granthaack/TinyTari/both.png

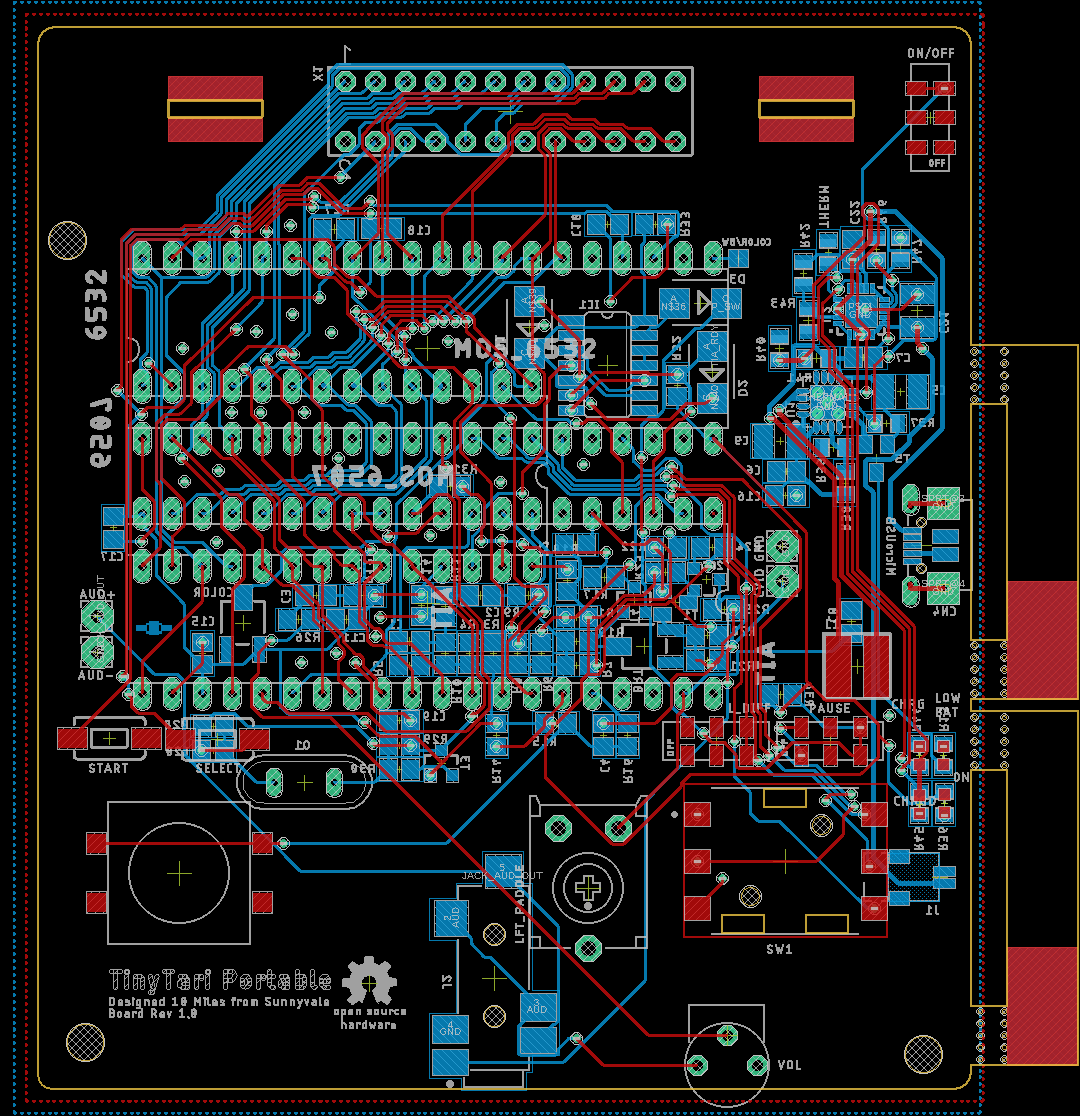
both.png
