granthaack/TinyTari/bottom.png

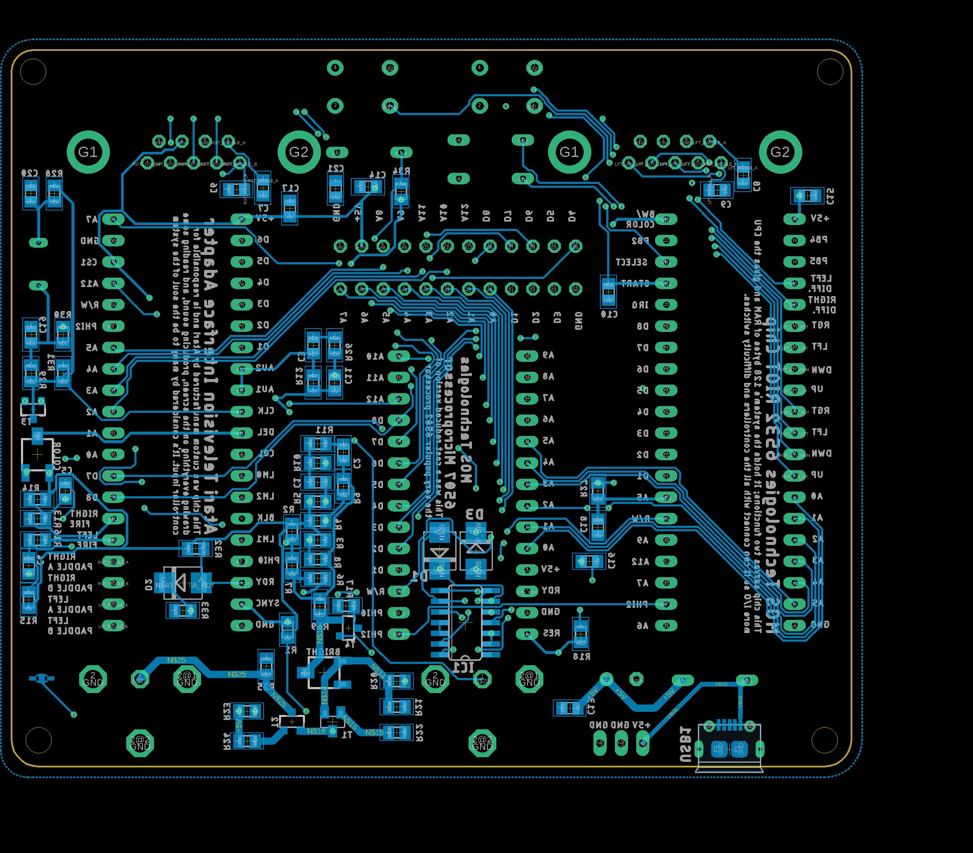
bottom.png
