granthaack/TinyTari/top.png

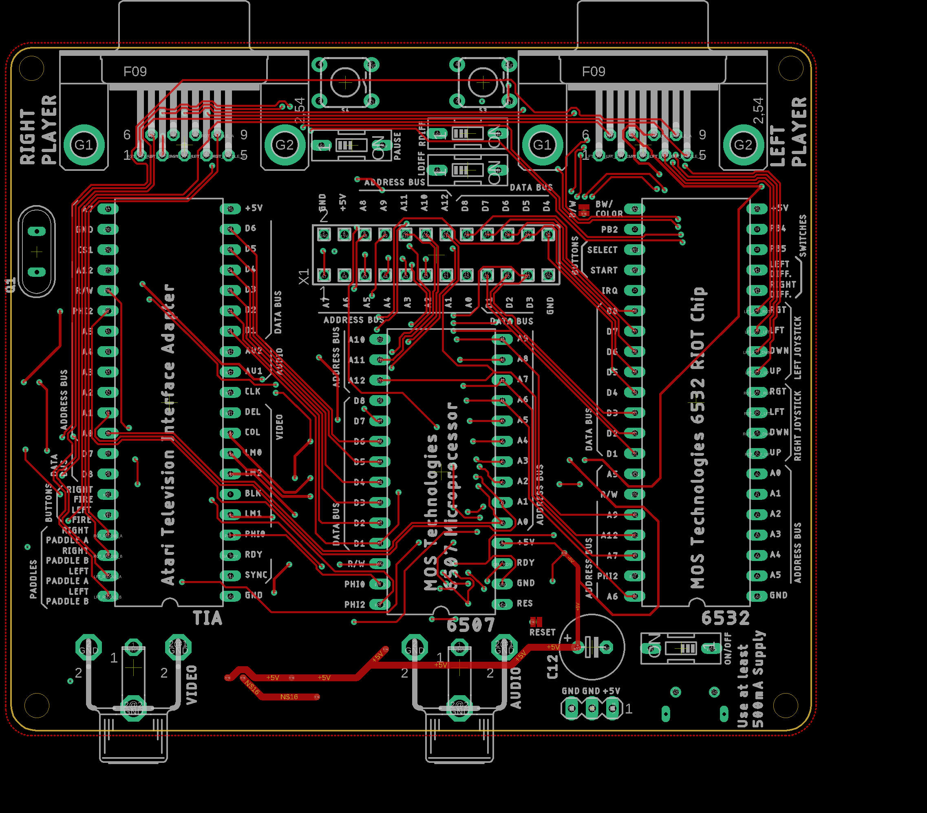
top.png
