granthaack/TinyTari/porta_stella.pdf

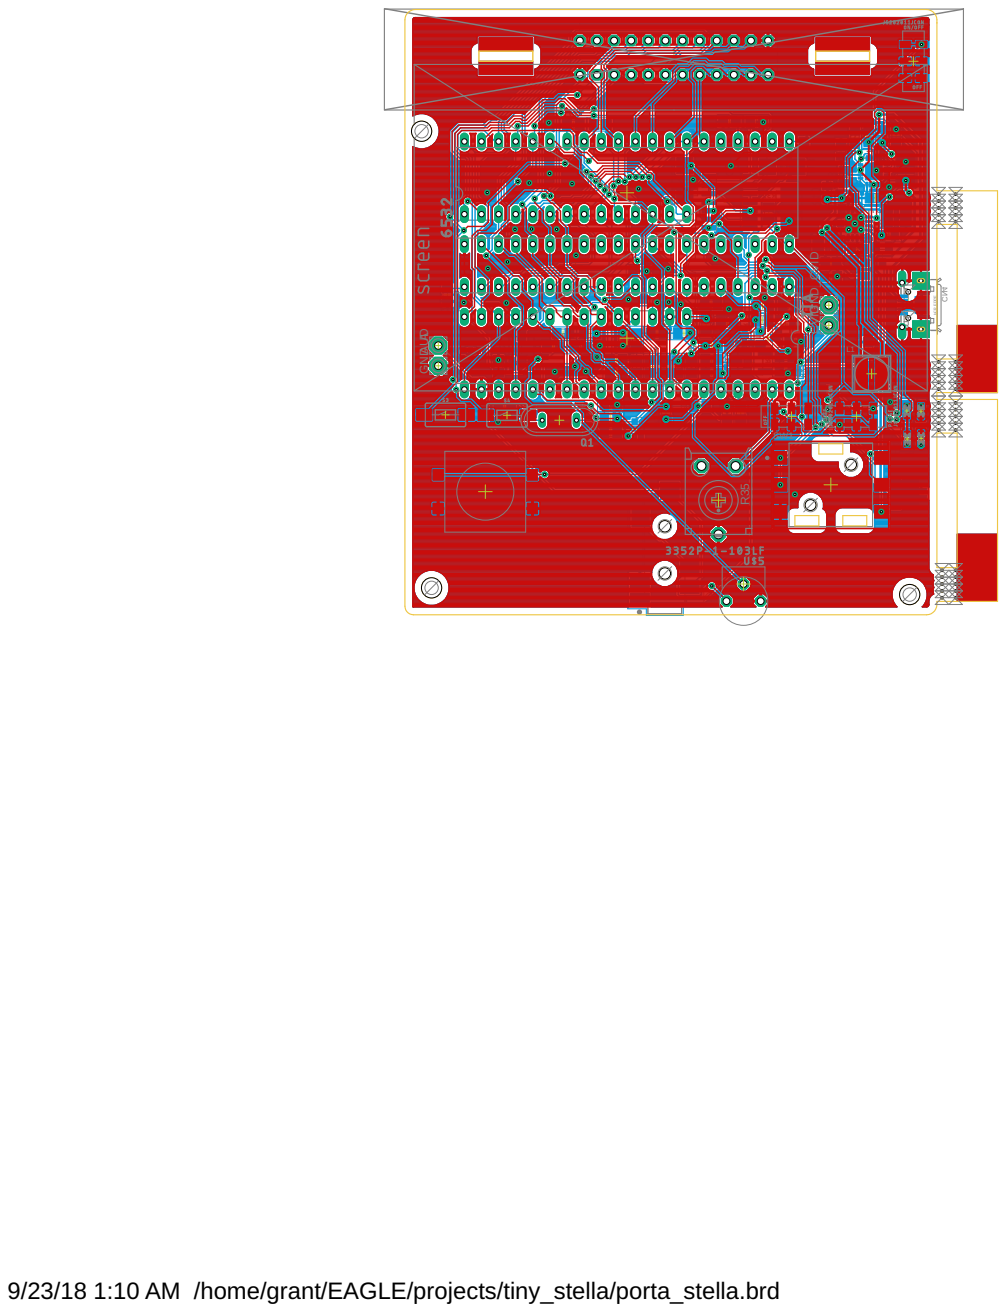
[picture p4: page 1]

9/23/18 1:10 AM /home/grant/EAGLE/projects/tiny_stella/porta_stella.brd
