granthaack/TinyTari/porta_stella.brd

## EAGLE design porta_stella.brd (2018-09-25)

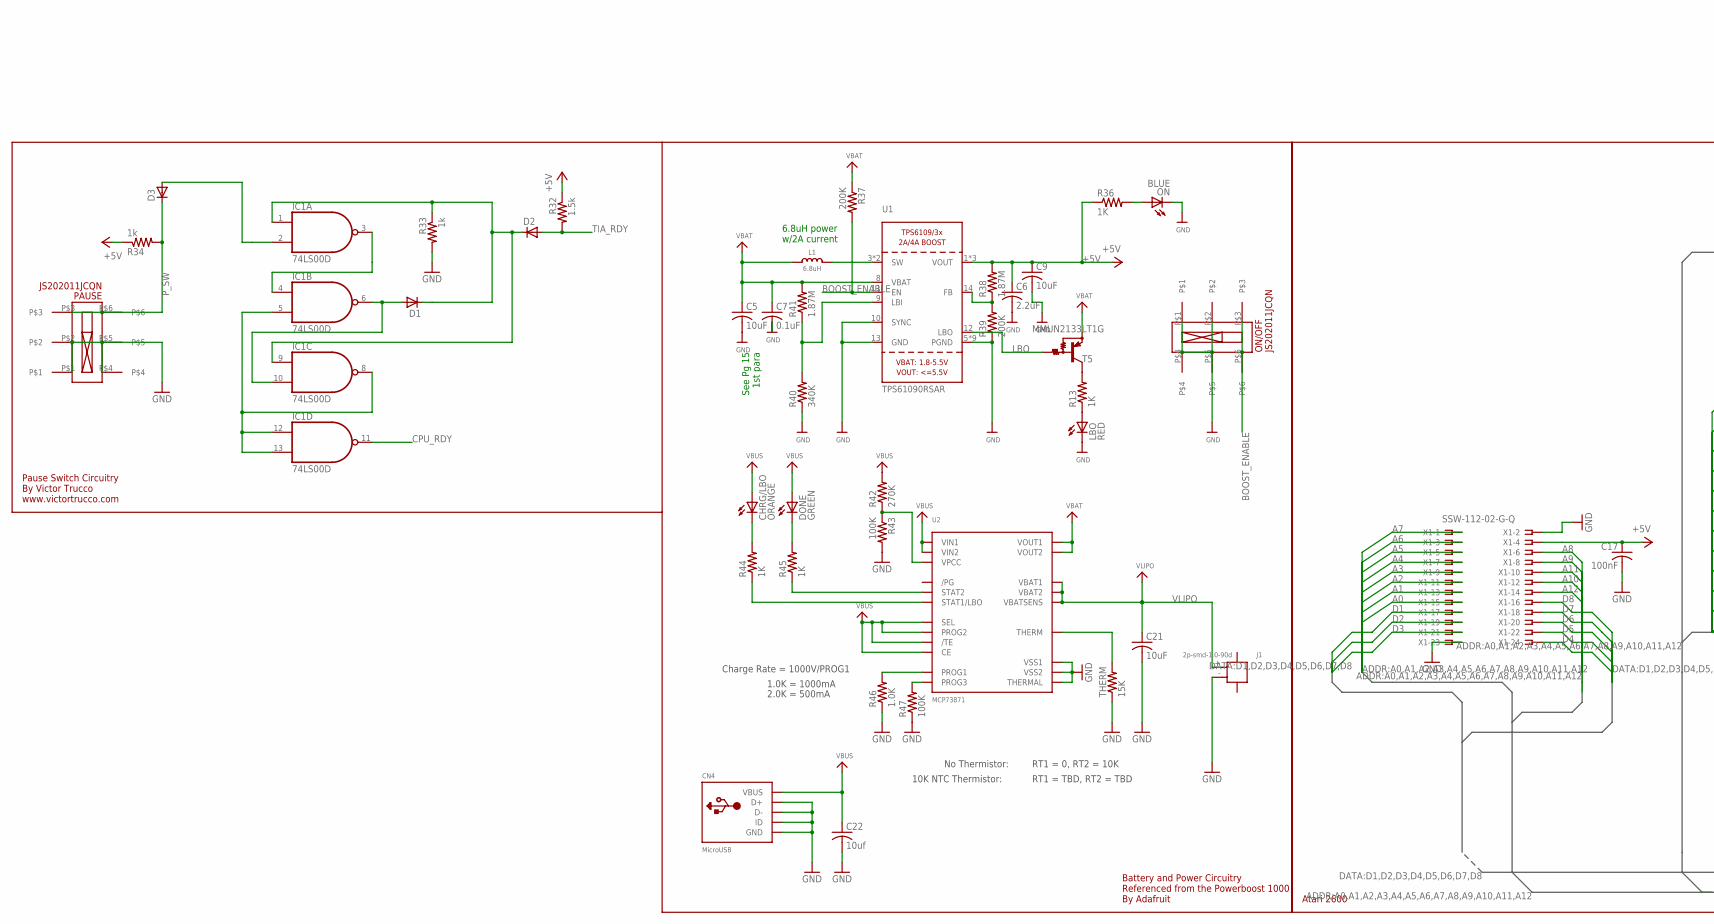
[picture p5: schematic porta_stella.sch, part in row 1, column 1]

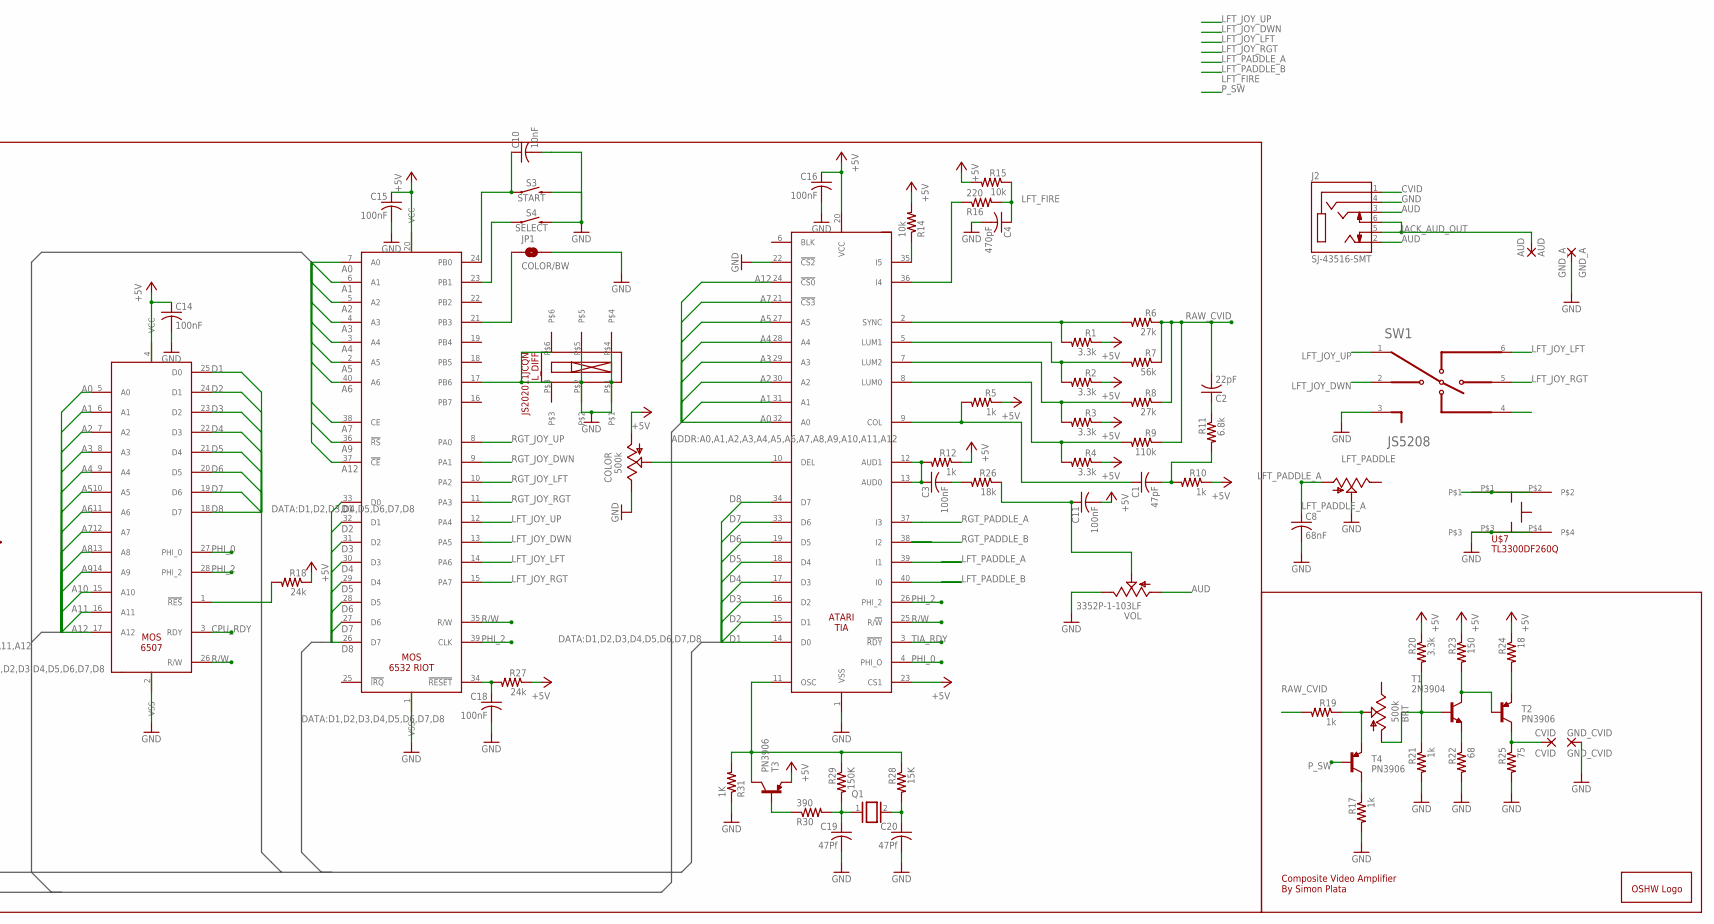
[picture p6: schematic porta_stella.sch, part in row 1, column 2]

Parts:
6507: MOS_6507; DIL28
6532: MOS_6532; DIL40
AUD: AUD; 2,54/1,1
BRT: 500k; 3223G
C1: 47pF; C0805
C2: 22pF; C0805
C3, C11, C14, C15, C16, C17, C18: 100nF; C0805
C4: 470pF; C0805
C5, C9, C21: 10uF; C1210
C6: 2.2uF; C0805
C7: 0.1uF; C0805
C8: 68nF; C0805
C10: 10nF; C0805
C19, C20: 47Pf; C0805
C22: 10uf; C0805
CHRG/LBO: ORANGE; ADAFRUIT_CHIPLED_0603
CN4: MicroUSB; 4UCONN_20329
COLOR: 500k; 3223G
CVID: CVID; 2,54/1,1
D1, D2, D3: DIODE_E-; DIODE_SMB
DONE: GREEN; ADAFRUIT_CHIPLED_0603
GND_A: GND_A; 2,54/1,1
GND_CVID: GND_CVID; 2,54/1,1
GOLD_ORB_SM1: OSHWLOGOLOGO5MM; OSHW_5MM
IC1: 74LS00D; SO14
J1: 2p-smd-1.0-90d; HW2-SMD-1.0-90D
J2: SJ-43516-SMT; CUI_SJ-43516-SMT
JP1: COLOR/BW; SMT-JUMPER_2_NO_NO-SILK
L1: 6.8uH; INDUCTOR_5X5MM_TDK_VLC5045
LBO: RED; ADAFRUIT_CHIPLED_0603
LFT_PADDLE: TRIM_US-ECP10S; ECP10S
L_DIFF: JS202011JCQN
ON: BLUE; ADAFRUIT_CHIPLED_0603
ON/OFF: JS202011JCQN
PAUSE: JS202011JCQN
Q1: XTAL/S; QS
R1, R2, R3, R4, R20: 3.3k; M0805
R5, R10, R12, R17, R19, R21, R33, R34: 1k; M0805
R6, R8: 27k; M0805
R7: 56k; M0805
R9: 110k; M0805
R11: 6.8k; M0805
R13, R36, R44, R45: 1K; R0805
R14, R15: 10k; M0805
R16: 220; M0805
R18, R27: 24k; M0805
R22: 68; M0805
R23: 150; M0805
R24: 18; M0805
R25: 75; M0805
R26: 18k; M0805
R28: 15K; M0805
R29: 150K; M0805
R30: 390; M0805
R31: 1K; M0805
R32: 1.5k; M0805
R37, R39: 200K; R0805
R38, R41: 1.87M; R0805
R40: 340K; R0805
R42: 270K; R0805
R43, R47: 100K; R0805
R46: 1.0K; R0805
S3: START; TACTILE_SWITCH_SMD_6.0X3.5MM
S4: SELECT; TACTILE_SWITCH_SMD_6.0X3.5MM
SW1: E-SWITCH_JS5208E-SWITCH_JS5208_0_0; E-SWITCH_JS5208_0
T1: 2N3904; SOT23-BEC
T2, T3, T4: PN3906; SOT23-3
T5: MMUN2133LT1G; TRANSISTOR_SC59-BEC
THERM: 15K; R0805
TIA: TIA; DIL40
U1: TPS61090RSAR; PVQFN-16
U2: MCP73871; QFN20_4MM
U$7: TL3300DF260Q
VOL: 3352P-1-103LF
X1: SSW-112-02-G-Q

Connections:
+5V: 6507.4 (VCC), 6532.20 (VCC), C6.1, C9.1, C11.2, C14.1, C15.1, C16.1, C17.1, COLOR.1 (A), R1.1, R2.1, R3.1, R4.1, R5.1, R10.1, R12.1, R14.2, R15.2, R18.1, R20.1, R23.1, R24.1, R27.1, R32.1, R34.1, R36.1, R38.2, T3.2 (E), TIA.20 (VCC), TIA.23 (CS1), U1.1 (VOUT), U1.15 (VOUT), U1.16 (VOUT), X1.4
A0: 6507.5 (A0), 6532.7 (A0), TIA.32 (A0), X1.15
A1: 6507.6 (A1), 6532.6 (A1), TIA.31 (A1), X1.13
A2: 6507.7 (A2), 6532.5 (A2), TIA.30 (A2), X1.11
A3: 6507.8 (A3), 6532.4 (A3), TIA.29 (A3), X1.9
A4: 6507.9 (A4), 6532.3 (A4), TIA.28 (A4), X1.7
A5: 6507.10 (A5), 6532.2 (A5), TIA.27 (A5), X1.5
A6: 6507.11 (A6), 6532.40 (A6), X1.3
A7: 6507.12 (A7), 6532.38 (CE), TIA.21 (!CS3), X1.1
A8: 6507.13 (A8), X1.6
A9: 6507.14 (A9), 6532.36 (!RS), X1.8
A10: 6507.15 (A10), X1.12
A11: 6507.16 (A11), X1.10
A12: 6507.17 (A12), 6532.37 (!CE), TIA.24 (!CS0), X1.14
AUD: J2.2 (TIP), J2.3 (RING1), VOL.P$1 (A)
BOOST_ENABLE: ON/OFF.P$3, ON/OFF.P$6, R37.2, U1.11 (EN)
CPU_RDY: 6507.3 (RDY), IC1.11 (O)
CVID: CVID.1, J2.1 (SLEEVE), R25.1, T2.3 (C)
D1: 6507.25 (D0), 6532.33 (D0), TIA.14 (D0), X1.17
D2: 6507.24 (D1), 6532.32 (D1), TIA.15 (D1), X1.19
D3: 6507.23 (D2), 6532.31 (D2), TIA.16 (D2), X1.21
D4: 6507.22 (D3), 6532.30 (D3), TIA.17 (D3), X1.24
D5: 6507.21 (D4), 6532.29 (D4), TIA.18 (D4), X1.22
D6: 6507.20 (D5), 6532.28 (D5), TIA.19 (D5), X1.20
D7: 6507.19 (D6), 6532.27 (D6), TIA.33 (D6), X1.18
D8: 6507.18 (D7), 6532.26 (D7), TIA.34 (D7), X1.16
GND: 6507.2 (VSS), 6532.1 (VSS), C4.2, C5.2, C6.2, C7.2, C8.2, C9.2, C10.2, C14.2, C15.2, C16.2, C17.2, C18.2, C19.2, C20.2, C21.2, C22.2, CN4.BASE@1 (GND), CN4.BASE@2 (GND), CN4.D+, CN4.D-, CN4.GND, CN4.ID, CN4.SPRT@1 (GND), CN4.SPRT@2 (GND), CN4.SPRT@3 (GND), CN4.SPRT@4 (GND), COLOR.3 (E), GND_A.1, GND_CVID.1, IC1.7 (GND), J1.- (2), J2.4 (RING2), JP1.2, LBO.C, LFT_PADDLE.S, L_DIFF.P$1, L_DIFF.P$2, L_DIFF.P$4, L_DIFF.P$5, ON.C, ON/OFF.P$1, ON/OFF.P$2, ON/OFF.P$4, ON/OFF.P$5, PAUSE.P$1, PAUSE.P$2, PAUSE.P$4, PAUSE.P$5, R17.2, R21.2, R22.2, R25.2, R31.1, R33.2, R39.1, R40.1, R43.2, R46.1, R47.1, S3.2, S4.2, SW1.3 (PUSH(N.O.)), THERM.1, TIA.1 (VSS), TIA.22 (!CS2), U1.5 (PGND), U1.6 (PGND), U1.7 (PGND), U1.10 (SYNC), U1.13 (GND), U1.P$18 (PGND), U1.P$19 (PGND), U1.P$20 (PGND), U1.P$21 (PGND), U1.P$22 (PGND), U1.THERMAL (PGND), U2.P$10 (VSS1), U2.P$11 (VSS2), U2.P$21 (THERMAL), U$7.P$3, U$7.P$4, VOL.P$2 (E), X1.2, X1.23
JACK_AUD_OUT: AUD.1, J2.5 (TIP_SWITCH), J2.6 (RING_SWITCH)
LBO: T5.B, U1.12 (LBO)
LFT_FIRE: C4.1, R15.1, R16.2, U$7.P$1, U$7.P$2
LFT_JOY_DWN: 6532.13 (PA5), SW1.2
LFT_JOY_LFT: 6532.14 (PA6), SW1.6
LFT_JOY_RGT: 6532.15 (PA7), SW1.5
LFT_JOY_UP: 6532.12 (PA4), SW1.1 (COMM.)
LFT_PADDLE_A: C8.1, LFT_PADDLE.A, TIA.39 (I1)
LFT_PADDLE_B: TIA.40 (I0)
unnamed: R1.2, R6.2, TIA.2 (SYNC)
unnamed: R2.2, R7.2, TIA.5 (LUM1)
unnamed: R3.2, R8.2, TIA.7 (LUM2)
unnamed: R4.2, R9.2, TIA.8 (LUM0)
unnamed: C1.1, R5.2, TIA.9 (COL)
unnamed: C1.2, R10.2, R11.2
unnamed: C2.1, R11.1
unnamed: R14.1, TIA.35 (I5)
unnamed: L1.P$2 (2), U1.3 (SW), U1.4 (SW)
unnamed: R16.1, TIA.36 (I4)
unnamed: R40.2, R41.1, U1.9 (LBI)
unnamed: BRT.2 (S), R19.1, T4.2 (E)
unnamed: BRT.1 (A), R20.2, R21.1, T1.B
unnamed: R22.1, T1.E
unnamed: R23.2, T1.C, T2.1 (B)
unnamed: COLOR.2 (S), TIA.10 (DEL)
unnamed: 6532.24 (PB0), C10.1, S3.1
unnamed: 6532.23 (PB1), S4.1
unnamed: 6532.21 (PB3), JP1.1
unnamed: 6532.17 (PB6), L_DIFF.P$3, L_DIFF.P$6
unnamed: LBO.A, R13.1
unnamed: 6507.1 (!RES), R18.2
unnamed: R24.2, T2.2 (E)
unnamed: C3.2, R26.2
unnamed: C3.1, R12.2, TIA.12 (AUD1), TIA.13 (AUD0)
unnamed: C11.1, R26.1, VOL.P$3 (S)
unnamed: 6532.34 (!RESET), C18.1, R27.2
unnamed: C20.1, Q1.2, R28.2
unnamed: C19.1, Q1.1, R29.2, R30.2
unnamed: R28.1, R29.1, R31.2, T3.3 (C), TIA.11 (OSC)
unnamed: R30.1, T3.1 (B)
unnamed: R17.1, T4.3 (C)
unnamed: IC1.5 (I1), IC1.8 (O), IC1.12 (I0), IC1.13 (I1)
unnamed: D3.A (C), IC1.2 (I1)
unnamed: R38.1, R39.2, U1.14 (FB)
unnamed: IC1.3 (O), IC1.4 (I0)
unnamed: D1.A (C), IC1.6 (O), IC1.10 (I1)
unnamed: D1.C (A), D2.C (A), IC1.1 (I0), IC1.9 (I0), R33.1
unnamed: R13.2, T5.C
unnamed: ON.A, R36.2
unnamed: R42.1, R43.1, U2.P$2 (VPCC)
unnamed: R45.1, U2.P$7 (STAT2)
unnamed: R44.1, U2.P$8 (STAT1/LBO)
unnamed: R46.2, U2.P$13 (PROG1)
unnamed: THERM.2, U2.P$5 (THERM)
unnamed: DONE.C, R45.2
unnamed: CHRG/LBO.C, R44.2
unnamed: R47.2, U2.P$12 (PROG3)
PHI_0: 6507.27 (PHI_0), TIA.4 (PHI_O)
PHI_2: 6507.28 (PHI_2), 6532.39 (CLK), TIA.26 (PHI_2)
P_SW: D3.C (A), PAUSE.P$3, PAUSE.P$6, R34.2, T4.1 (B)
R/W: 6507.26 (R/W), 6532.35 (R/W), TIA.25 (R/!W)
RAW_CVID: C2.2, R6.1, R7.1, R8.1, R9.1, R19.2
RGT_JOY_DWN: 6532.9 (PA1)
RGT_JOY_LFT: 6532.10 (PA2)
RGT_JOY_RGT: 6532.11 (PA3)
RGT_JOY_UP: 6532.8 (PA0)
RGT_PADDLE_A: TIA.37 (I3)
RGT_PADDLE_B: TIA.38 (I2)
TIA_RDY: D2.A (C), R32.2, TIA.3 (!RDY)
VBAT: C5.1, C7.1, L1.P$1 (1), R37.1, R41.2, T5.E, U1.8 (VBAT), U2.P$1 (VOUT1), U2.P$20 (VOUT2)
VBUS: C22.1, CHRG/LBO.A, CN4.VBUS, DONE.A, R42.2, U2.P$3 (SEL), U2.P$4 (PROG2), U2.P$9 (/TE), U2.P$17 (CE), U2.P$18 (VIN1), U2.P$19 (VIN2)
VCC: IC1.14 (VCC)
VLIPO: C21.1, J1.+ (1), U2.P$14 (VBAT1), U2.P$15 (VBAT2), U2.P$16 (VBATSENS)

Notes on the sheet:
See Pg 15 1st para
6.8uH power w/2A current
Charge Rate = 1000V/PROG1
1.0K = 1000mA
2.0K = 500mA
No Thermistor:
10K NTC Thermistor:
RT1 = 0, RT2 = 10K
RT1 = TBD, RT2 = TBD
Battery and Power Circuitry Referenced from the Powerboost 1000 By Adafruit
Pause Switch Circuitry By Victor Trucco www.victortrucco.com
Atari 2600
Composite Video Amplifier By Simon Plata

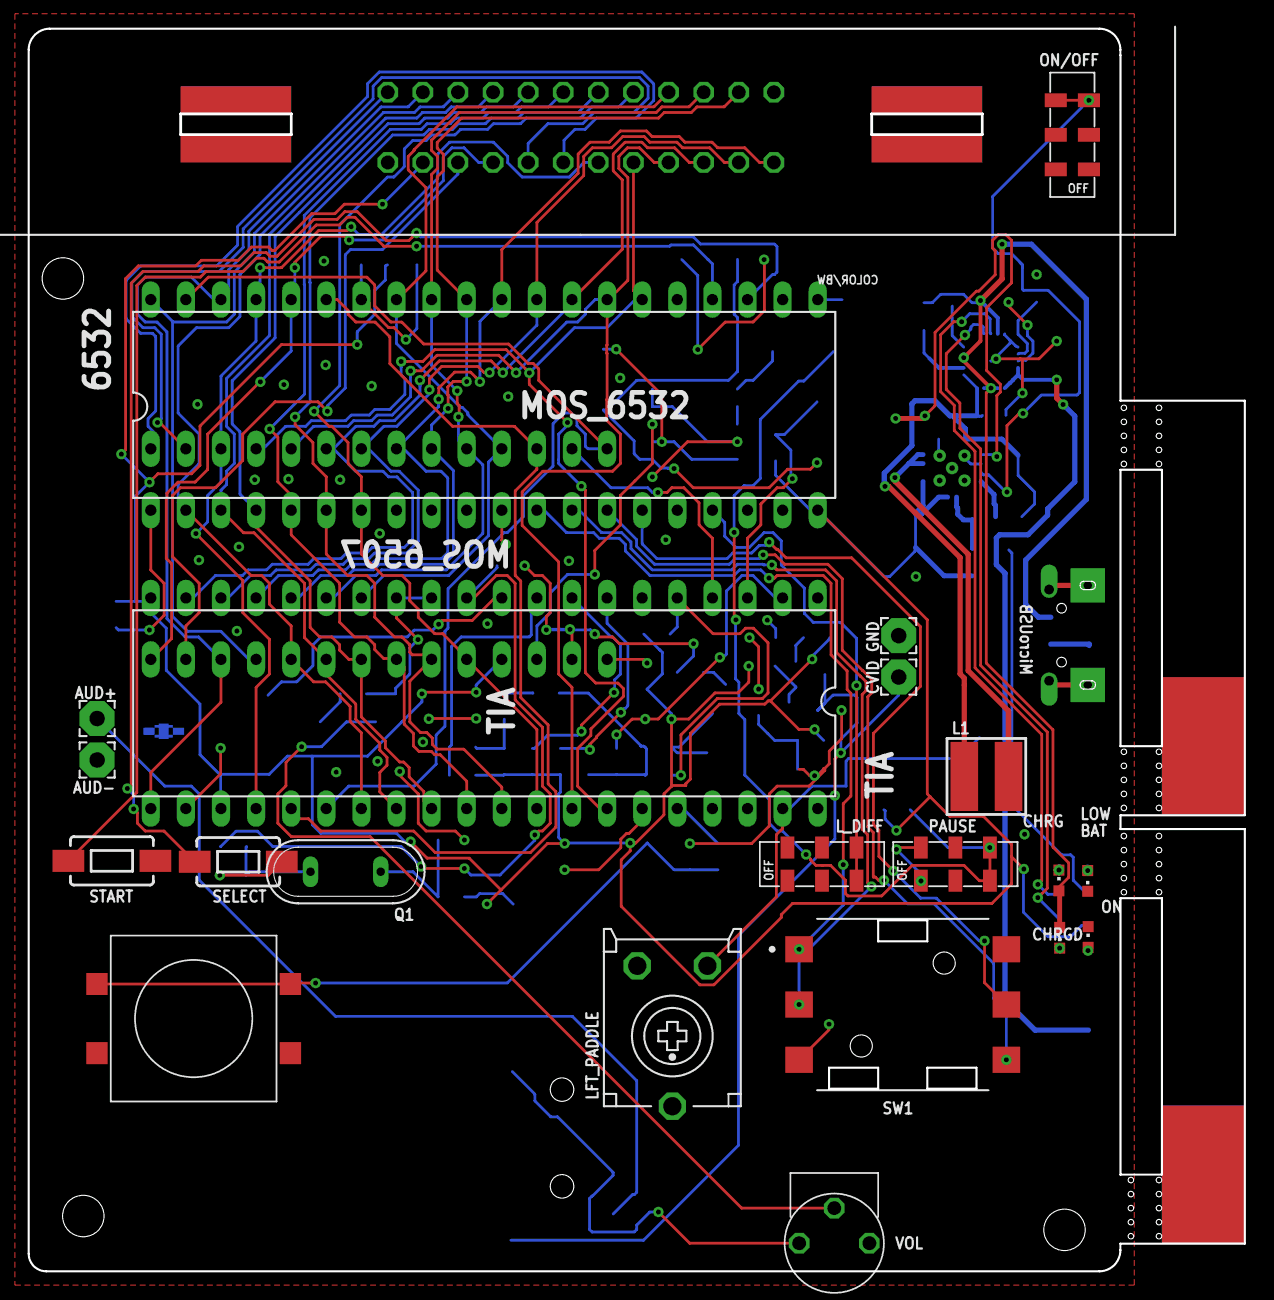
[picture p7: board porta_stella.brd from above]

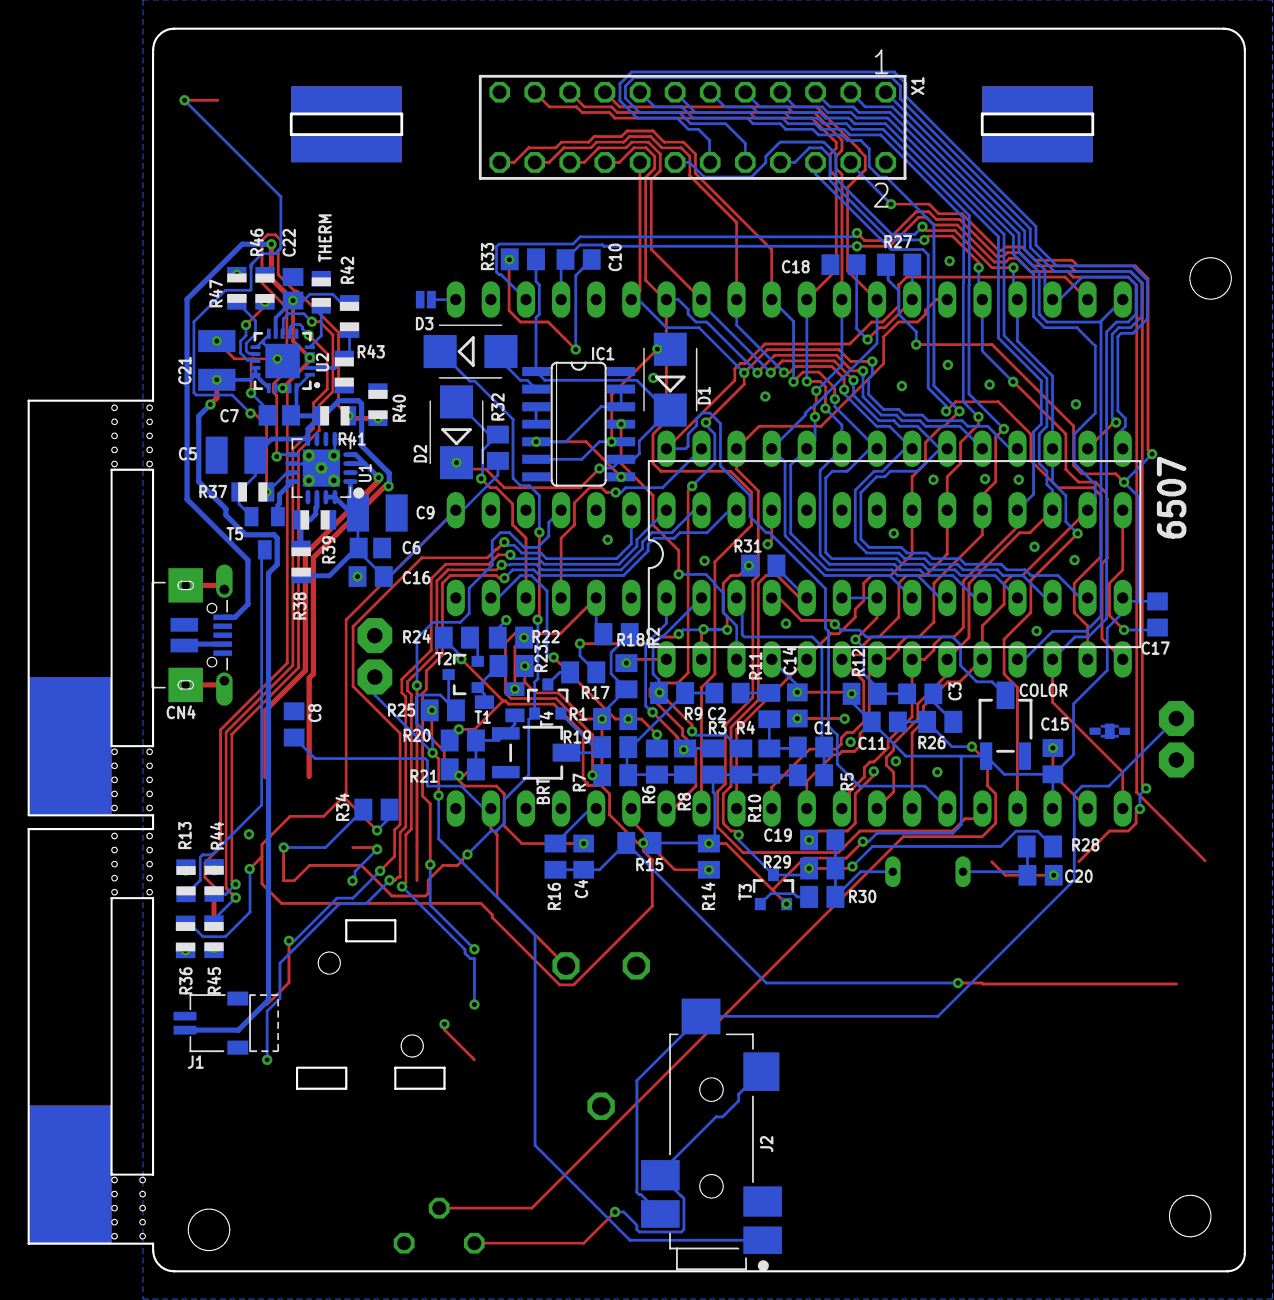
[picture p8: board porta_stella.brd from below]

Board: 2 copper layers, 88.0 x 89.9 mm, 108 parts (86 on the bottom side), 92 nets.
