granthaack/TinyTari/(commit log)

2018-09-03 labeled everything and started laying traces
    [tiny_stella.brd, tiny_stella.sch]
2018-09-03 more traces
    [tiny_stella.brd]
2018-09-04 added pausing circuitry
    [tiny_stella.brd, tiny_stella.sch]
2018-09-04 more routing
    [tiny_stella.brd]
2018-09-04 even more routing
    [tiny_stella.brd]
2018-09-04 added breakout for the power
    [tiny_stella.brd, tiny_stella.sch]
2018-09-05 swapped the left and right joystick inputs'
    '
    [tiny_stella.brd, tiny_stella.csv]
2018-09-05 added monogram
    [tiny_stella.brd]
2018-09-05 silkscreen work
    [tiny_stella.brd, tiny_stella.sch]
2018-09-05 yet more silkscreen
    [tiny_stella.brd, tiny_stella.sch]
2018-09-05 finished silkscreen, probably ready for manufacturing
    [tiny_stella.brd, tiny_stella.sch]
2018-09-06 started work on portable version
    [porta_stella.brd, porta_stella.sch]
2018-09-07 more layout work for handheld
    [porta_stella.brd, porta_stella.sch]
2018-09-07 Started work on controller daughterboard
    [porta_stella.brd, porta_stella.sch]
2018-09-07 reworked the shape
    [porta_stella.brd, porta_stella.sch]
2018-09-09 more trace work
    [porta_stella.brd]
2018-09-12 included measurements of the screen
    [porta_stella.brd, porta_stella.sch]
2018-09-12 resized again to make more room for the joystick
    [porta_stella.brd, porta_stella.sch]
2018-09-12 switched to gameboy form factor
    [porta_stella.brd, porta_stella.sch]
2018-09-13 Added new switch
    [porta_stella.brd, porta_stella.sch]
2018-09-15 ready to finish wiring
    [porta_stella.brd, porta_stella.sch]
2018-09-23 Finished traces, just need to label components:
    [porta_stella.brd, porta_stella.sch]
2018-09-24 ready for manufacturing
    [porta_stella.brd, porta_stella.sch]
2018-09-25 worked on the BOM
    [porta_stella.brd, porta_stella.csv]
2018-10-07 made gerbers and added a to fix list for rev1.1
    [porta_stella.GBL, porta_stella.GBO, porta_stella.GBP, porta_stella.GBS, porta_stella.GTL, porta_stella.GTO, porta_stella.GTP, porta_stella.GTS]
